electrickery/logicTester/firstPrototype.jpg

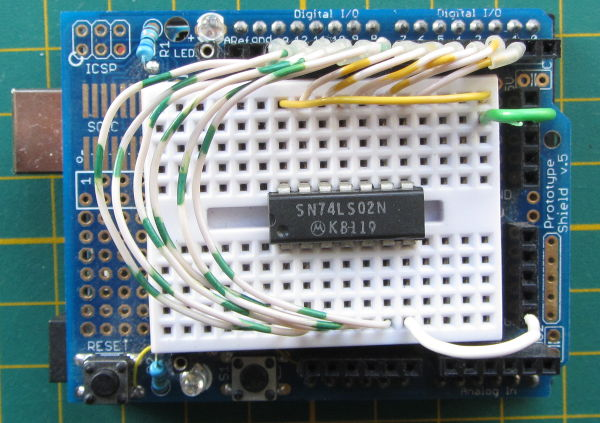
firstPrototype.jpg
