electrickery/logicTester/pin14power.png

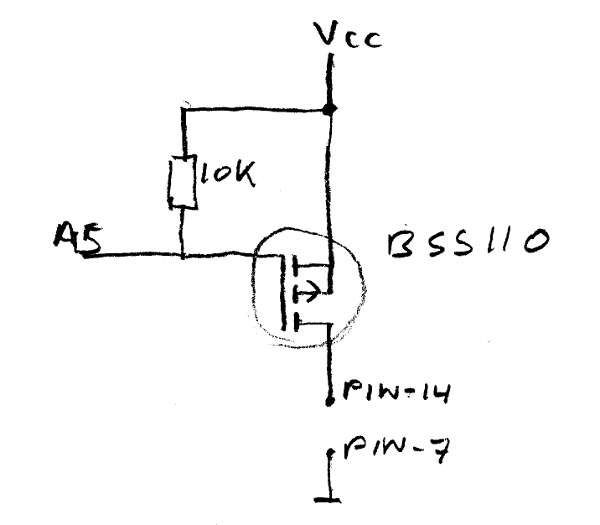
pin14power.png
