electrickery/logicTester/thirdPrototype.jpg

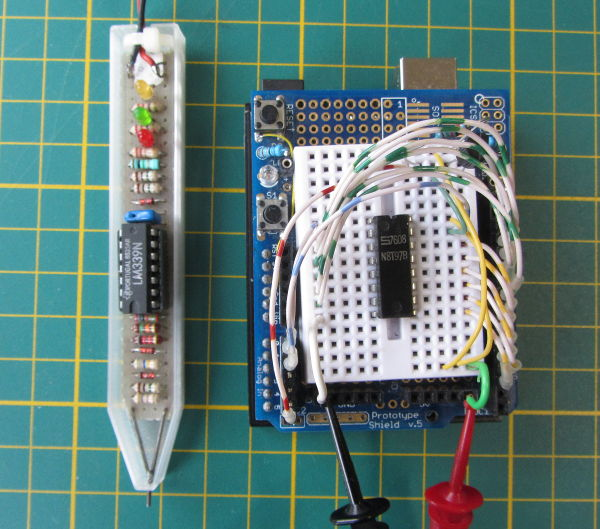
thirdPrototype.jpg
