electrickery/logicTester/schemav1.4.pdf

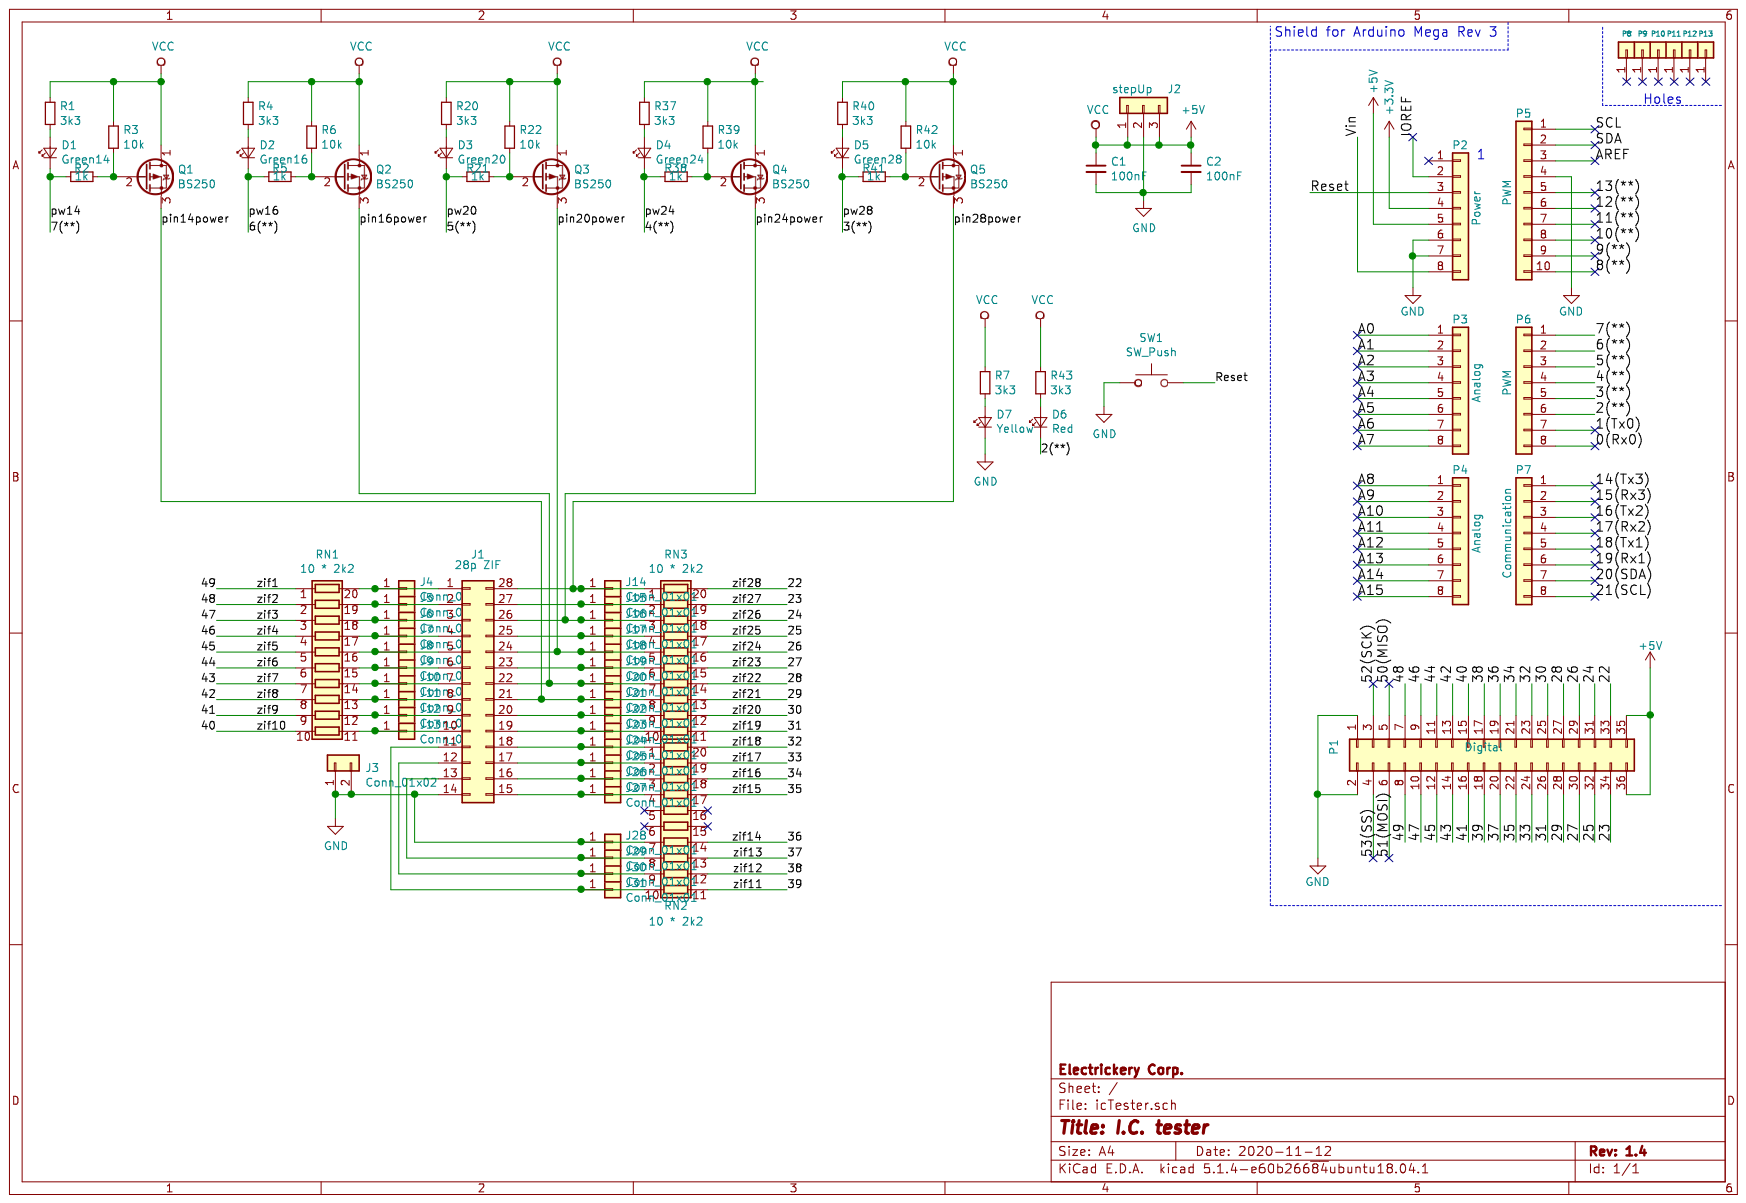
[picture p5: page 1]
