electrickery/logicTester/ICtestMega2/ICtestMega2.ino

/*  IC-test 2 client(Arduino)-server(Python script)
 *   
 *   
 *   Assuming 74LS00 quad NAND
 *   Config command:
 *   C:1,2,Q,4,5,Q,G,Q,9,10,Q,12,13,V
 *   Query command:
 *   Q:0,0,-,0,0,-,G,-,0,0,-,0,0,V
 *   Response:
 *   R:0,0,1,0,0,1,G,1,0,0,1,0.0,V
 *   Q:0,0,-,0,0,-,G,-,0,0,-,0,1,V
 *   R:0,0,1,0,0,1,G,1,0,0,0,1,1,V
 *   ....
 *   Q:1,1,-,1,1,-,G,-,1,1,-,1,1,V
 *   R:1,1,0,1,1,0,G,0,1,1,0,1,1,V
 *  
 */

#include "pinMap.h"

#define VERSION 1.4

#define DEFAULT_DEBUG 0
#define BAUDRATE 115200

#define SERIALBUFSIZE         65
char serialBuffer[SERIALBUFSIZE];
byte setBufPointer = 0;

#define PIN_SEPARATOR   ','
#define EXERCISE_PIN    'E'
#define CLOCK_PIN       'C'
#define INV_CLOCK_PIN   'c'
#define QUERY_PIN       'Q'
#define GROUND_PIN      'G'
#define POWER_PIN       'V'
#define QUERY_CHAR      '-'

#define CLOCK_PULSE     1L
#define EXERCISE_PIN_DELAY 250
#define INPUT_CHANGE_DELAY 1L

byte pinType[MAX_PINCOUNT];
byte pinCount = 0;
byte debug = DEFAULT_DEBUG;
byte powerAPin = 0;

void setup() {
  Serial.begin(BAUDRATE);
  clearPins();
  delay(10);
  Serial.print("Arduino Mega IC tester ");
  Serial.println(VERSION,1);
}

void loop() {
    commandCollector();


}

void commandCollector() {
  if (Serial.available() > 0) {
    int inByte = Serial.read();
    switch(inByte) {
    case '.':
//    case '\r':
    case '\n':
      commandInterpreter();
      clearSerialBuffer();
      setBufPointer = 0;
      break;
    case '\r':
      break;  // ignore carriage return
    default:
      serialBuffer[setBufPointer] = inByte;
      setBufPointer++;
      if (setBufPointer >= SERIALBUFSIZE) {
        Serial.println("ERROR: Serial buffer overflow. Cleanup.");
        clearSerialBuffer();
        setBufPointer = 0;
      }
    }
  }
}

void commandInterpreter() {
  byte bufByte = serialBuffer[0];
  
  switch(bufByte) {
    case 'C':
    case 'c':
      configurePins();
      break;
    case 'D':
    case 'd':
      if (setBufPointer > 2)
        debug = (serialBuffer[2] == '1') ? 1 : 0;
        Serial.print("Debug: ");
        Serial.println(debug);
       break;
    case 'E':
    case 'e':
      exerciseICPin();
      break;
    case 'F':
    case 'f':
      errorLed();
      break;
    case 'H':
    case 'h':
    case '?':
      usage();
      break;
    case 'P':
    case 'p':
      exercisePowerPin();
      break;
    case 'Q':
    case 'q':
      setQueryThePins();
      break;
    case 'R':
    case 'r':
      resetThePins();
      break;
    case 'Z':
    case 'z':
      tristateTest();
      break;
    default:
      Serial.print((char)bufByte);
      Serial.print(" ");
      Serial.println("unsupported");
      return;
  }
}

void usage() {
  Serial.print("ICtest ");
  Serial.println(VERSION,1);

  Serial.println("C - configure pins");
  Serial.println("D - debug mode");
  Serial.println("E - exercise pin with 500ms cycle");
  Serial.println("F - control error LED");
  Serial.println("H - this text");
  Serial.println("P - exercise power pin with 500ms cycle");
  Serial.println("Q - set and query pins");
  Serial.println("R - reset config and pins");
  Serial.println("Z - test for tri-state output");
}

void exerciseICPin() {
  char *parseBuf = &serialBuffer[2];
  String parseStr = parseBuf;
  byte pinNo = str2int(parseStr);
  if (pinNo == 0) return;
  byte pinIndex = pinNo - 1;
  pinMode(pinMap[pinIndex], OUTPUT);
  while (Serial.available() <= 0) {
    Serial.print("IC: ");
    Serial.print(pinNo);
    exercisePin(pinIndex);
  }
  pinMode(pinMap[pinIndex], INPUT);
}

void exercisePowerPin() {
  char *parseBuf = &serialBuffer[2];
  String parseStr = parseBuf;
  byte pinNo = str2int(parseStr);
  if (pinNo == 0) return;
  while (Serial.available() <= 0) {
    switch(pinNo) {
      case 14:
        pinMode(power14, OUTPUT);
        Serial.print("Pw: ");
        Serial.print(power14);
        exercisePin(power14);
        pinMode(power14, INPUT);
        break;
      case 16:
        pinMode(power16, OUTPUT);
        Serial.print("Pw: ");
        Serial.print(power16);
        exercisePin(power16);
        pinMode(power16, INPUT);
        break;
      case 20:
        pinMode(power20, OUTPUT);
        Serial.print("Pw: ");
        Serial.print(power20);
        exercisePin(power20);
        pinMode(power20, INPUT);
        break;
      case 24:
        pinMode(power24, OUTPUT);
        Serial.print("Pw: ");
        Serial.print(power24);
        exercisePin(power24);
        pinMode(power24, INPUT);
        break;
      case 28:
        pinMode(power28, OUTPUT);
        Serial.print("Pw: ");
        Serial.print(power28);
        exercisePin(power28);
        pinMode(power28, INPUT);
        break;
      default:
        Serial.print(pinNo);
        Serial.print(" ");
        Serial.println("unsupported");
        return;
    }
  }
}

void exercisePin(byte pinNo) {
  while (Serial.available() <= 0) {
    digitalWrite(pinNo, HIGH);
    Serial.print(pinNo);
    Serial.print(" HIGH");
    delay(EXERCISE_PIN_DELAY);
    digitalWrite(pinNo, LOW);
    Serial.println(" LOW");
    delay(EXERCISE_PIN_DELAY);
  }
}

void errorLed() {
  char *parseBuf = &serialBuffer[2];

  if (parseBuf[0] == '1') { // LED on
    pinMode(errorPin, OUTPUT);
    digitalWrite(errorPin, LOW); 
  } else {                  // LED off
    pinMode(errorPin, INPUT);
    digitalWrite(errorPin, HIGH); 
  }
}

void tristateTest() {
  char *parseBuf = &serialBuffer[2];
  String parseStr = parseBuf;
  byte pinNo = str2int(parseStr); 
  byte pinIndex = pinNo - 1;
  byte pullupValue;
  byte noPullupValue;
  pinMode(pinMap[pinIndex], INPUT);
  delay(INPUT_CHANGE_DELAY);
  noPullupValue = digitalRead(pinMap[pinIndex]);
  pinMode(pinMap[pinIndex], INPUT_PULLUP);
  delay(INPUT_CHANGE_DELAY);
  pullupValue = digitalRead(pinMap[pinIndex]);
  Serial.print("pin: ");
  Serial.print(pinNo);
  Serial.print(" = ");
  if (noPullupValue == pullupValue) {
    Serial.println((pullupValue == 0) ? "L" : "H");
  } else {
    Serial.println("Z");
  }
}

void enablePowerPin(byte pinCount) {
  if (pinCount == 14) {
    powerAPin = power14;
  } else if (pinCount == 16) {
    powerAPin = power16;
  } else if (pinCount == 20) {
    powerAPin = power20;
  } else if (pinCount == 24) {
    powerAPin = power24;
  } else if (pinCount == 28) {
    powerAPin = power28;
  } else {
    Serial.print("pinCount: ");
    Serial.print(pinCount);
    Serial.println(" unsupported.");
    return;
  }
  pinMode(powerAPin, OUTPUT);
  digitalWrite(powerAPin, LOW);
}

void configurePins() {
  // C:1,2,Q,4,5,Q,G,Q,9,10,Q,12,13,V  (7400)
  // C:1,2,3,4,5,6,Q,G,Q,Q,Q,Q,Q,Q,Q,V (74138)
  clearPins();
  pinCount = getPinDef();
  bool err = 0;
  enablePowerPin(pinCount);
  for (byte i = 0; i < pinCount; i++) {
    logPinConf(i);
    if (pinType[i] == EXERCISE_PIN) {
      pinMode(pinMap[i], OUTPUT);
    } else if (pinType[i] == QUERY_PIN) {
      pinMode(pinMap[i], INPUT_PULLUP);
    } else if (pinType[i] == GROUND_PIN) {
      // ignore
    } else if (pinType[i] == POWER_PIN) {
      // ignore
    } else if (pinType[i] == CLOCK_PIN) { // raising flank clock
      pinMode(pinMap[i], OUTPUT);
      digitalWrite(pinMap[i], LOW);
    } else if (pinType[i] == INV_CLOCK_PIN) { // falling flank clock
      pinMode(pinMap[i], OUTPUT);
      digitalWrite(pinMap[i], HIGH);
    } else {
      Serial.print("ERROR: config ");
      Serial.print(i);
      Serial.print(" ");
      Serial.println((char)pinType[i]);
      err = 1;
    }
  }
  if (err) {
    Serial.println("ERROR");
  } else {
    Serial.println("OK");
  }
}

void logPinConf(byte i) {
  if (!debug) return;
    Serial.print("'");
    Serial.print(i + 1);
    Serial.print(" [");
    Serial.print(pinMap[i]);
    Serial.print("]: ");
    Serial.print((char)pinType[i]);
    Serial.println();
}

byte getPinDef() {
  byte pinCount = countPins();
  switch(pinCount) {
    case 14:
      pinMap = pins14;
      break;
    case 16:
      pinMap = pins16;
      break;
    case 20:
      pinMap = pins20;
      break;
    case 24:
      pinMap = pins24;
      break;
    case 28:
      pinMap = pins28;
      break;
    default:
      Serial.print("ERROR: pin count ");
      Serial.print(pinCount);
      Serial.println(" unsupported");
      return;
  }
  byte separatorIndex = 0;
  char *parseBuf = &serialBuffer[2];
  String parseStr = parseBuf;
  int pinNum = 0;
  for (int i = 0; i < pinCount; i++) {
    separatorIndex = parseStr.indexOf(PIN_SEPARATOR);
    if (isNumeric(parseStr.charAt(0))) {
        pinType[i] = EXERCISE_PIN;
    } else { 
        pinType[i] = parseStr.charAt(0);
    }
    parseStr = parseStr.substring(separatorIndex + 1);
  }
  return pinCount;
}

byte countPins() { // C:1,2,Q,4,5,Q,G,Q,9,10,Q,12,13,V
  byte pinCount = 0;
  for (int i = 0; i < SERIALBUFSIZE; i++) {
    char c = serialBuffer[i];
    if (i < 2) continue; // ignore the header chars "C:"
      if (serialBuffer[i] == PIN_SEPARATOR) {
        pinCount++;
    }
  }
  return pinCount + 1;
}

void setQueryThePins() { // Q:0,0,-,0,0,-,G,-,0,0,-,0,0,V
  if (pinCount == 0) {
    Serial.println("ERROR: pins not configured");
    return;
  }
  byte separatorIndex = 0;
  char *parseBuf = &serialBuffer[2]; // remove leading 'Q:'
  String parseStr = parseBuf;

  for (int i = 0; i < pinCount; i++) { // setting non-clock pins
    separatorIndex = parseStr.indexOf(PIN_SEPARATOR);
    if (pinType[i] != CLOCK_PIN && pinType[i] != INV_CLOCK_PIN) {
      if (parseStr.charAt(0) == '0' && pinMap[i] != 0) {
          digitalWrite(pinMap[i], 0);
      } else if (parseStr.charAt(0) == '1' && pinMap[i] != 0) {
          digitalWrite(pinMap[i], 1);
      } else { // ignore other pins
          
      }
      parseStr = parseStr.substring(separatorIndex + 1);
    }
  }
  for (int i = 0; i < pinCount; i++) { // setting clock pins
    separatorIndex = parseStr.indexOf(PIN_SEPARATOR);
    if (pinType[i] == CLOCK_PIN && parseStr.charAt(0) == '1' && pinMap[i] != 0) {
        digitalWrite(pinMap[i], HIGH);
        delay(CLOCK_PULSE);
        digitalWrite(pinMap[i], LOW);
    } else if (pinType[i] == INV_CLOCK_PIN && parseStr.charAt(0) == '1' && pinMap[i] != 0) {
        digitalWrite(pinMap[i], LOW);
        delay(CLOCK_PULSE);
        digitalWrite(pinMap[i], HIGH);
    } else { // ignore other pins
        
    }
    parseStr = parseStr.substring(separatorIndex + 1);
  }
  parseStr = parseBuf;
  String response = "R:";
  for (int i = 0; i < pinCount; i++) { // querying
    separatorIndex = parseStr.indexOf(PIN_SEPARATOR);
    logQuery(i);
    if (pinType[i] == GROUND_PIN || pinType[i] == POWER_PIN) {
      response = String(response + (char)pinType[i]);
    } else if (isBoolean(parseStr.charAt(0))) {
      response = String(response + parseStr.charAt(0));
    } else  if (parseStr.charAt(0) == QUERY_CHAR) {
//      response = String(response + digitalRead(pinMap[i]));
      response = String(response + ((digitalRead(pinMap[i])) ? "H" : "L"));
    } else {
      Serial.println("ERROR: unknown pin type or query character");
    }
    parseStr = parseStr.substring(separatorIndex + 1);
    if (i < pinCount -1) response = String(response + ",");
  }
  Serial.println(response);
}

void logQuery(byte i) {
    if (!debug) return;
    Serial.print("'");
    Serial.print(i + 1);
    Serial.print(" [");
    Serial.print(pinMap[i]);
    Serial.print("]: ");
    if (pinType[i] == GROUND_PIN || pinType[i] == POWER_PIN) {
      Serial.println((char)pinType[i]);
    } else {
      Serial.println(digitalRead(pinMap[i]));
    }
    if (pinCount == 14)
      Serial.println("Power to 14 pin");
}

void resetThePins() {
  pinCount = 0;
  clearPins();
  for (int i = 0; i < MAX_PINCOUNT; i++) {
    pinMode(pinMap[i], INPUT);
  }
  byte ePinCount = 0;
  while (extraPins[ePinCount] != 0) {
    digitalWrite(extraPins[ePinCount], HIGH);
    pinMode(extraPins[ePinCount], INPUT);
    ePinCount++;
  }

  Serial.println("OK");
}

void clearPins() {
  for (int i = 0; i < MAX_PINCOUNT; i++) pinType[i] = 0;
}

void clearSerialBuffer() {
  byte i;
  for (i = 0; i < SERIALBUFSIZE; i++) {
    serialBuffer[i] = 0;
  }
}

bool isNumeric(char c) {
  return (c >= '0' && c <= '9');
}

bool isBoolean(char c) {
  return (c >= '0' && c <= '1');
}

int str2int(String str) {
  int i;
  if(sscanf(str.c_str(), "%2d", &i) != 1) {
     Serial.println("ERROR");
     return 0;
  }
//  i = atoi(str.c_str());
  return i;
}
