electrickery/logicTester/(commit log)

2020-10-04 First working prototype.
2020-10-08 Update of the matching Arduino code.
2020-10-10 power switching for pin 14; Arduino stand-alone commands.
2020-10-12 - Added Hackaday URL to README.md - Added PCB design v1.0 zip - Added experimental tri-state text code to Arduino
2020-11-17 some more ic's & reset mode.
    [evalTest.py, icTest.py]
2023-02-10 Fixed library file name error.
    [icTest.py]
2026-02-17 Minor fix and a new IC: 7474.
    [icTest.py]
2026-02-17 The same v1.0 board design, but plotted with KiCAD 9.0.
2026-02-19 A more complete set of gerbers and drill files.
